zebra1993/SN2_Extension/SNModule.pdf

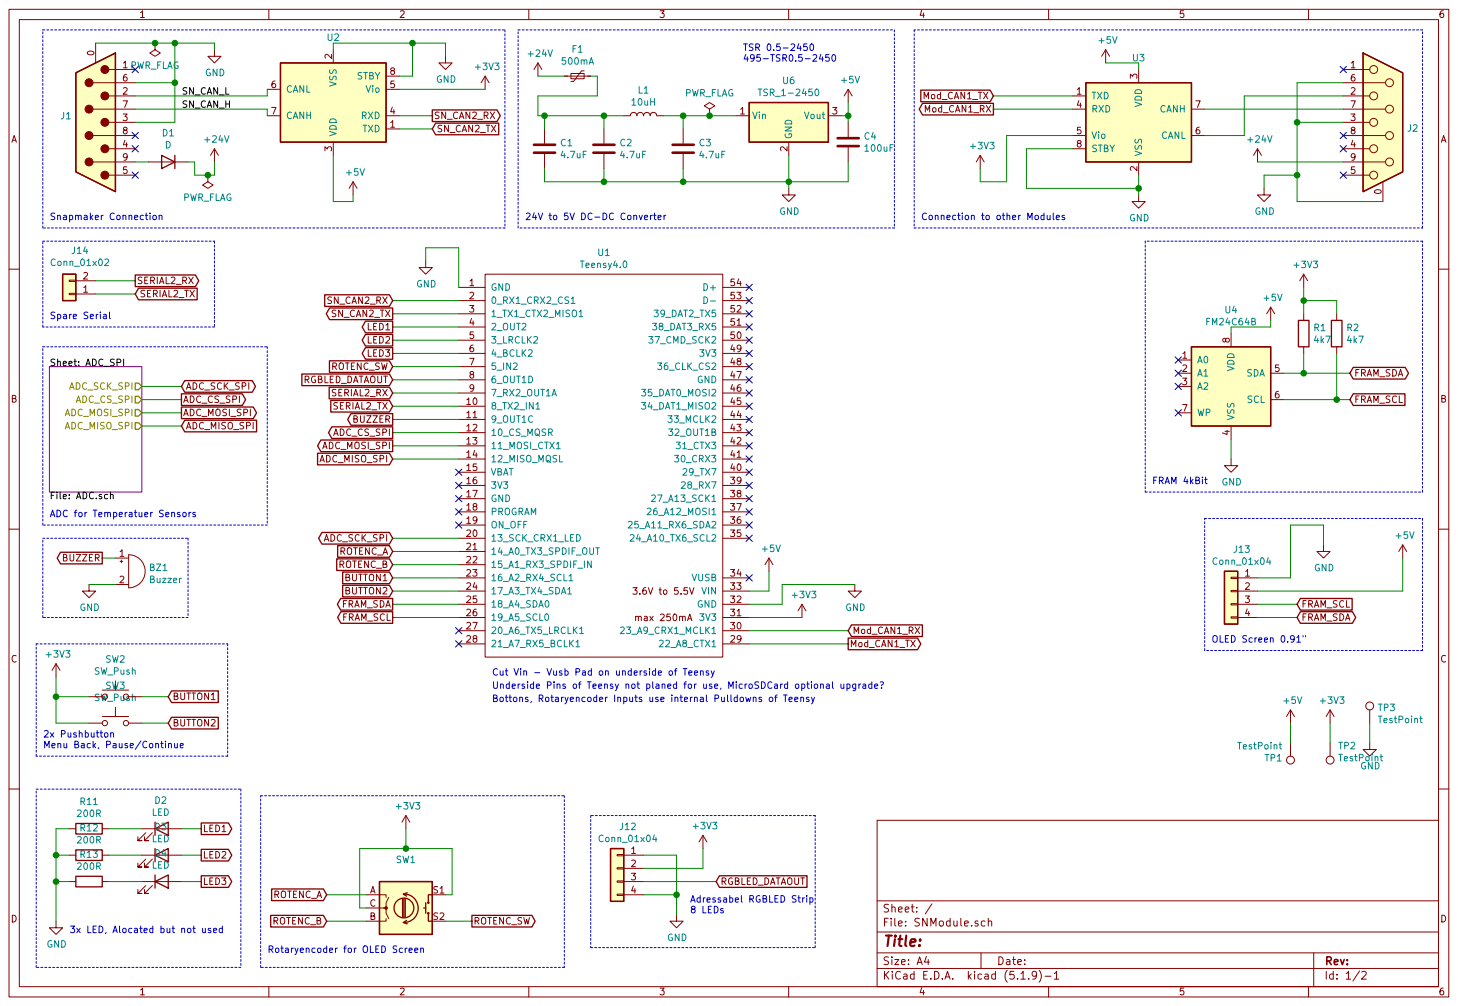
[picture p1: page 1]

3 RXD 4 Vio 5 CANL 6 CANH 7 STBY 8 U2 +24V

3 RXD 4 Vio 5 CANL 6 CANH 7 STBY 8 U3 GND GND

4 SDA 5 SCL 6 WP 7 VDD

8 LEDs Cut Vin - Vusb Pad on underside of Teensy
Underside Pins of Teensy not planed for use, MicroSDCard optional upgrade?

Id: 1/2 Title: File: SNModule.sch Sheet: /

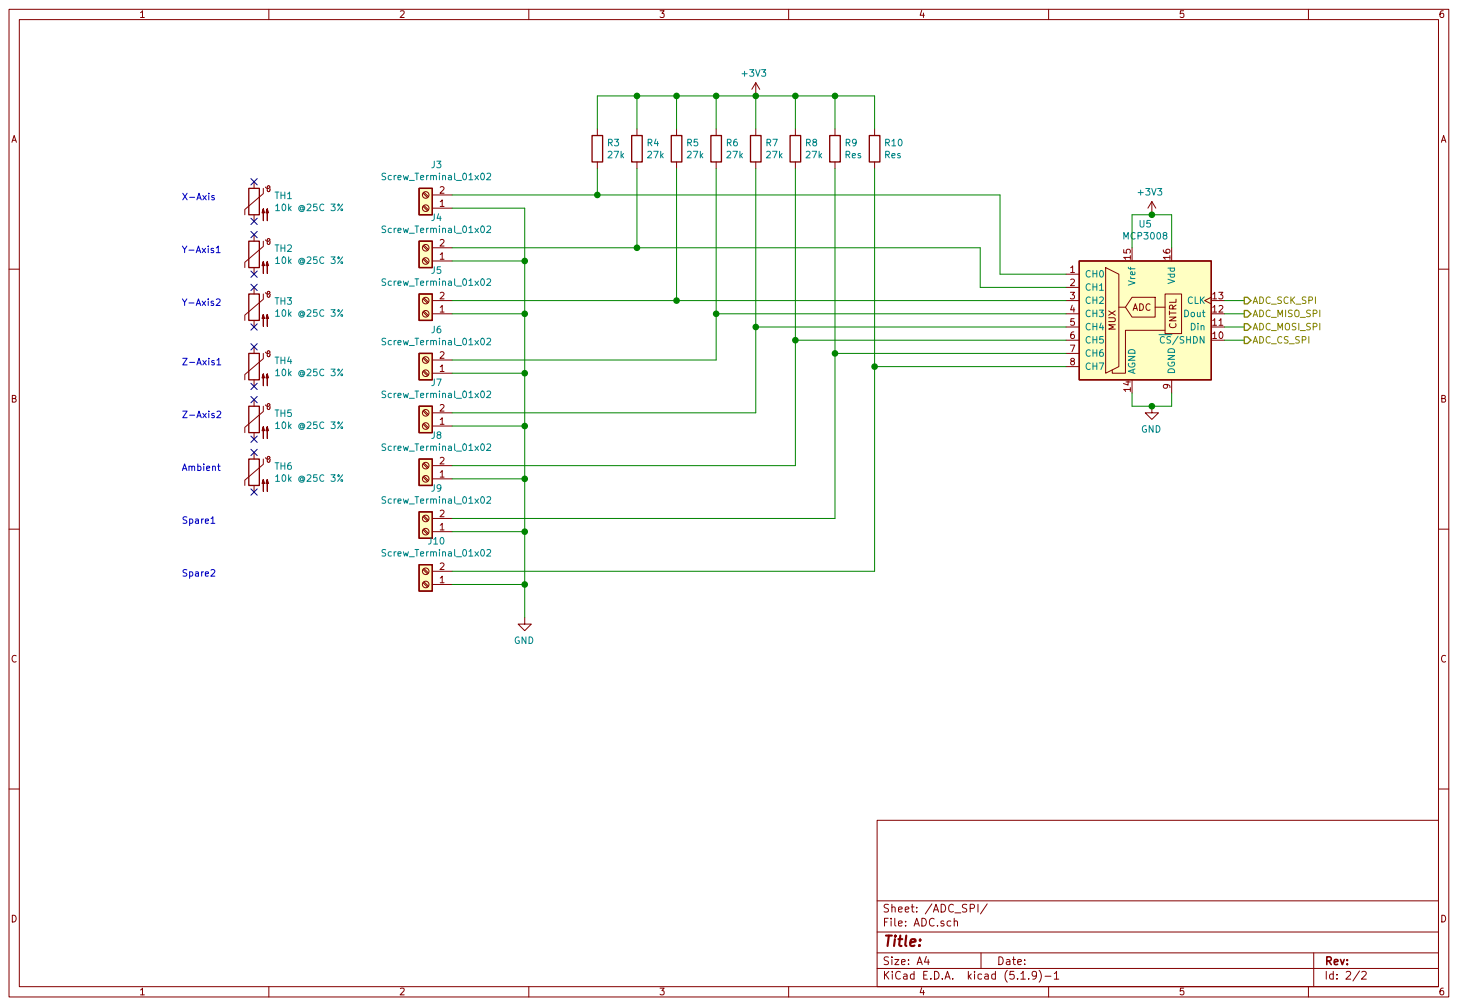
[picture p2: page 2]

Id: 2/2 Title: File: ADC.sch Sheet: /ADC_SPI/
