zebra1993/SN2_Extension/PCB_V1.pdf

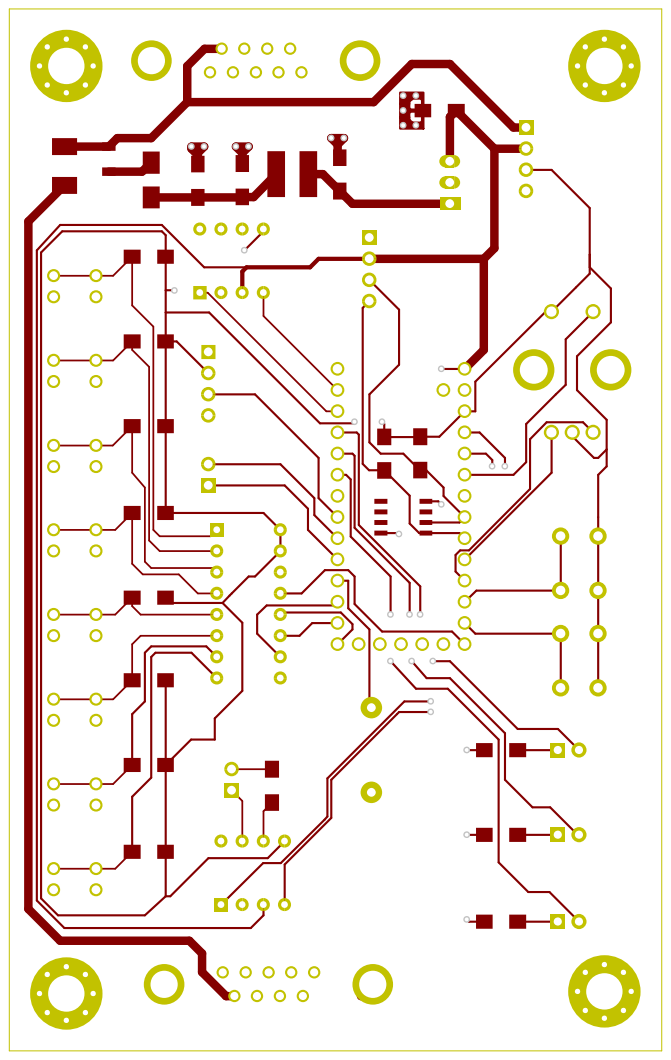
[picture p3: page 1]

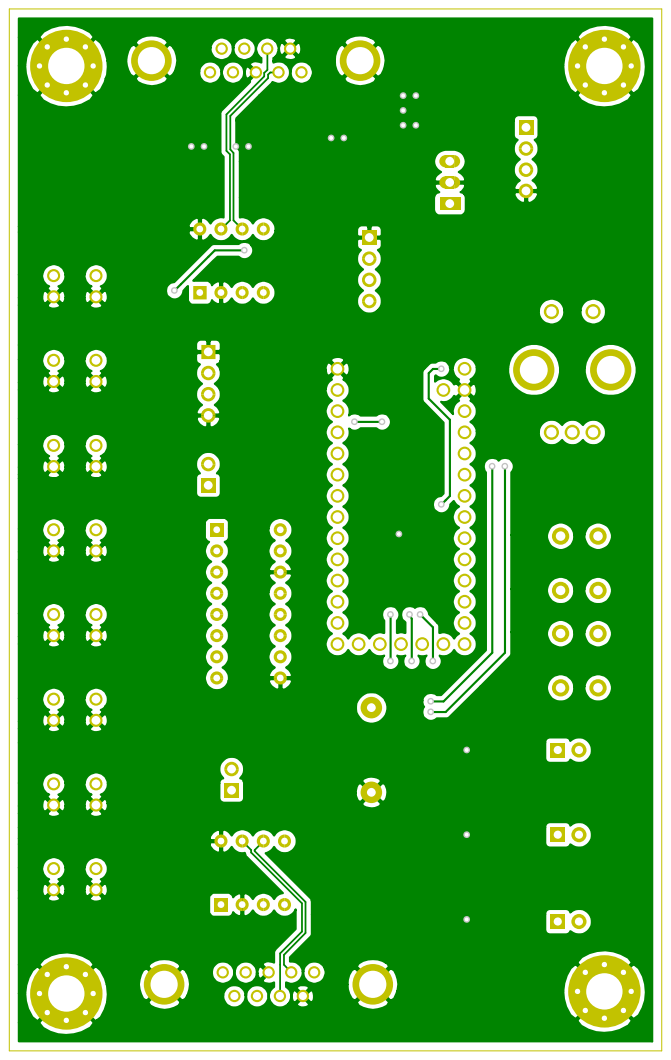
[picture p4: page 2]

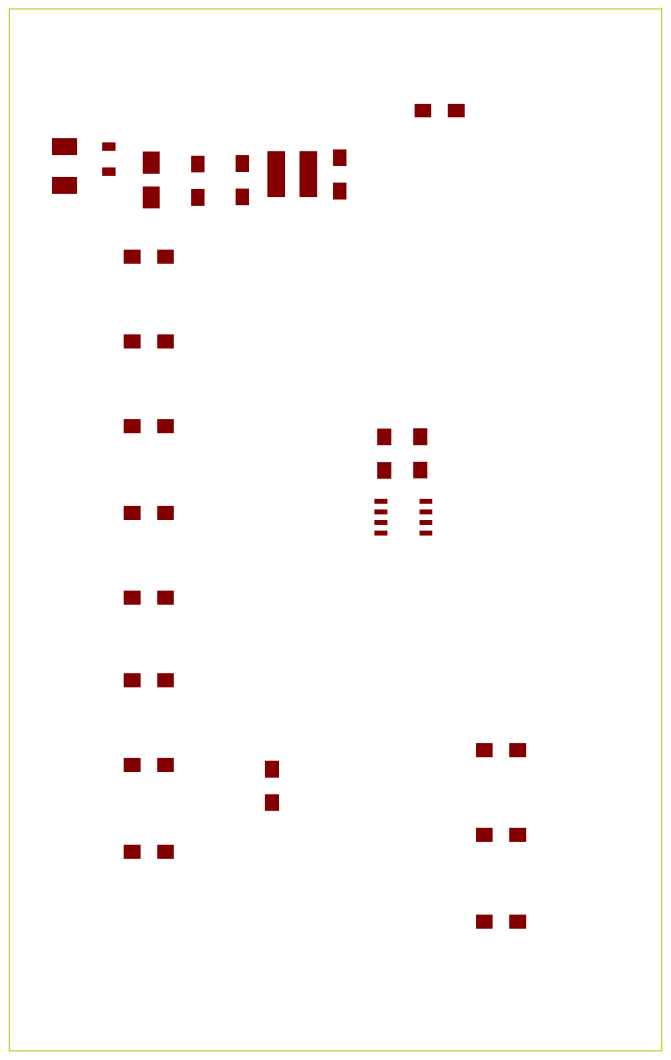
[picture p5: page 3]

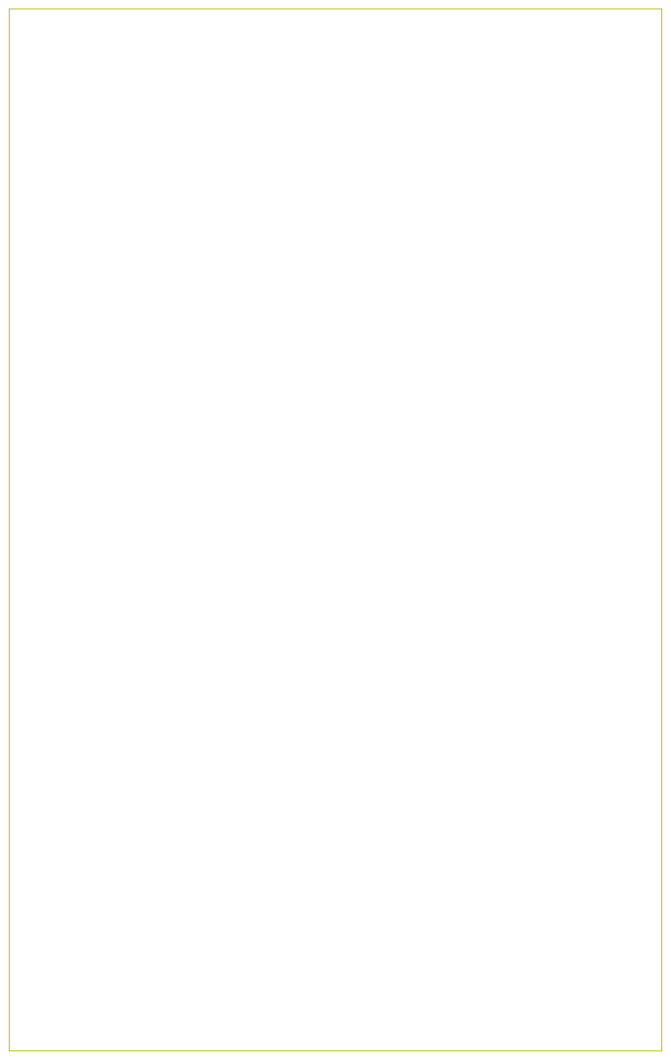
[picture p6: page 4]

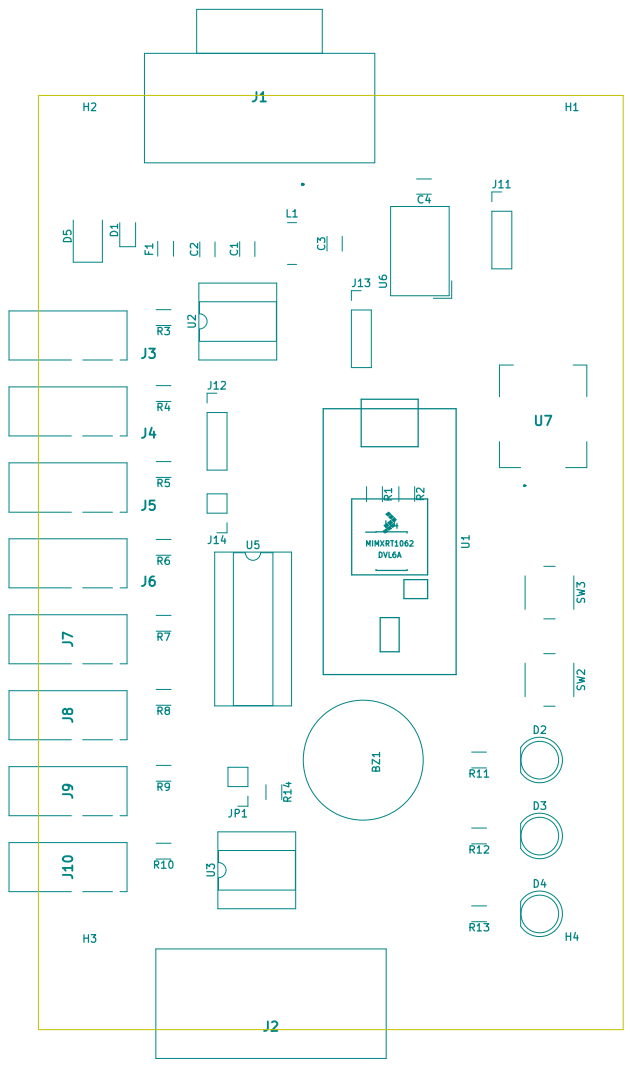
[picture p7: page 5]

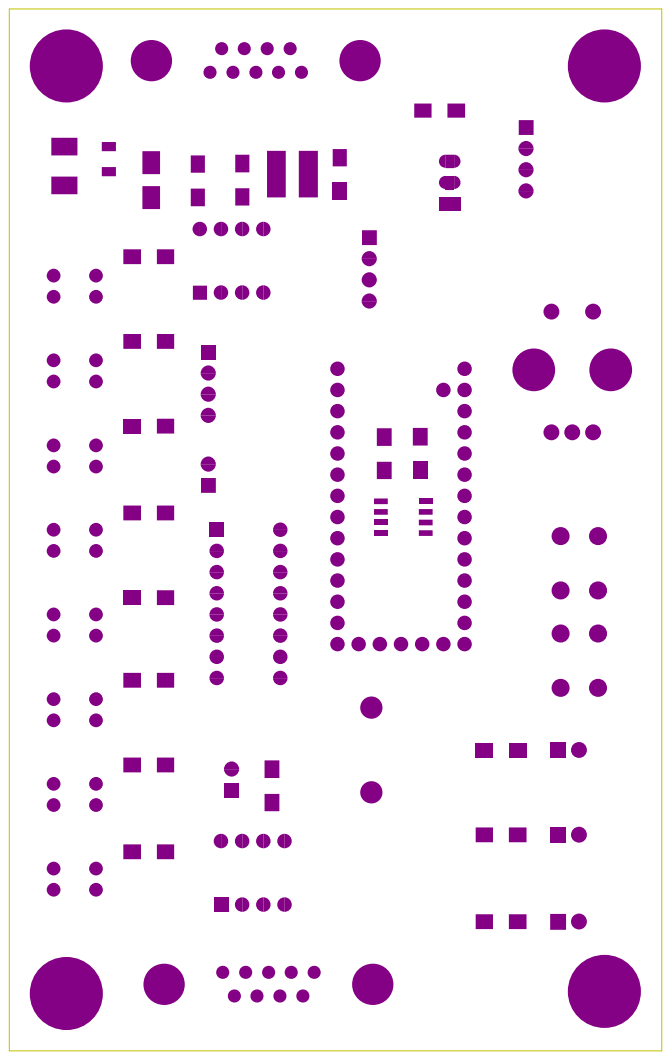
[picture p8: page 7]

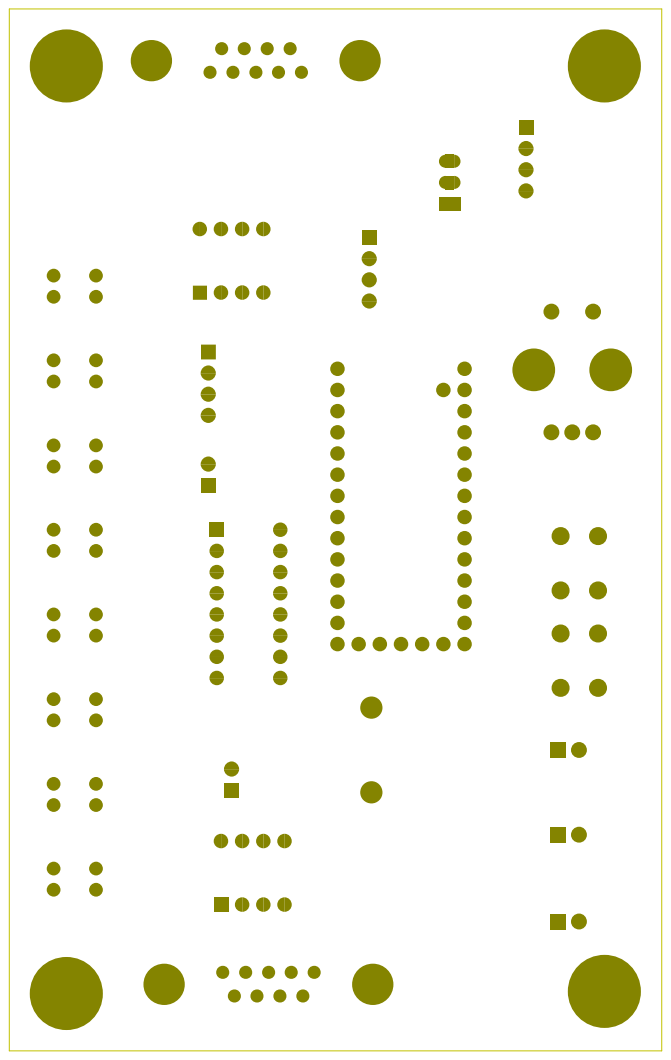
[picture p9: page 8]

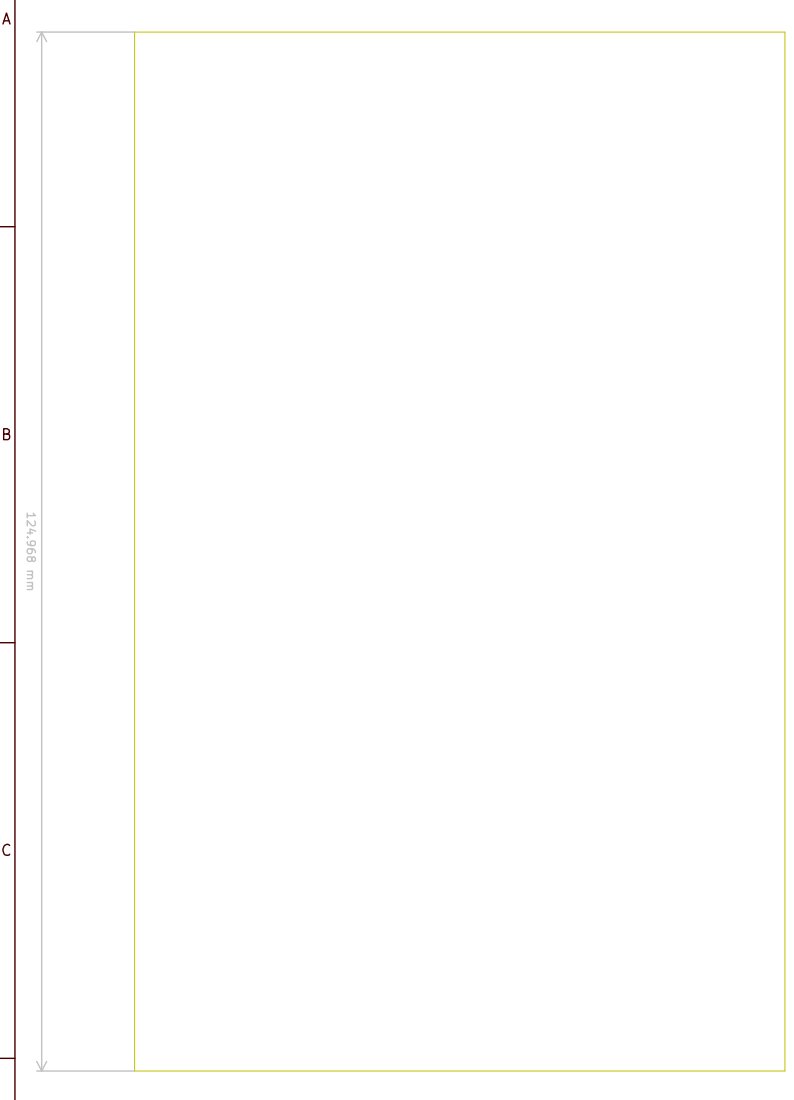
[picture p10: page 9]

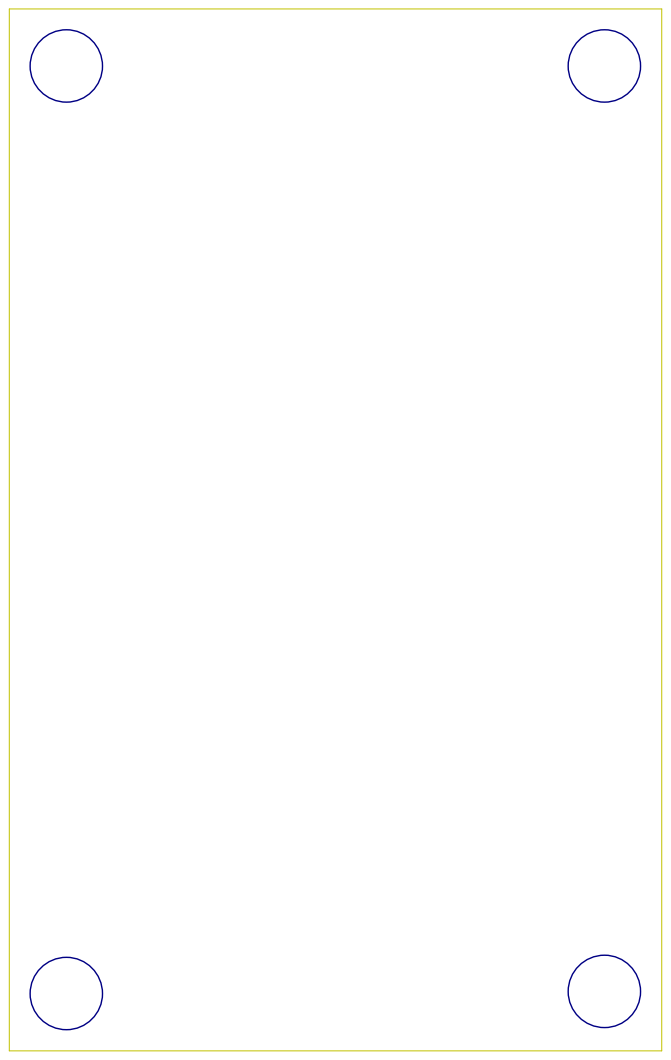
[picture p11: page 10]

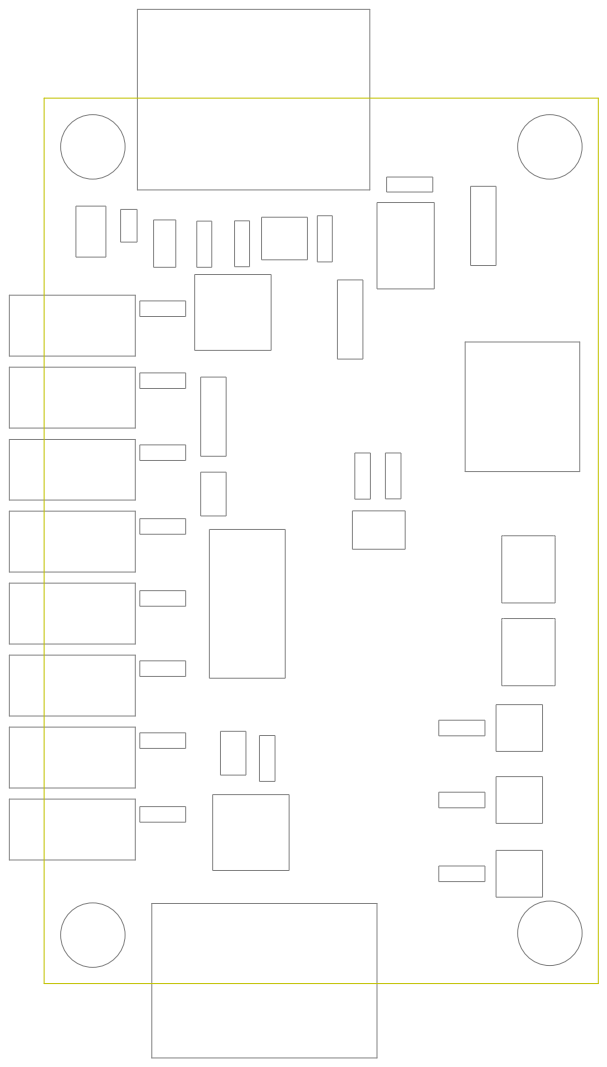
[picture p12: page 15]

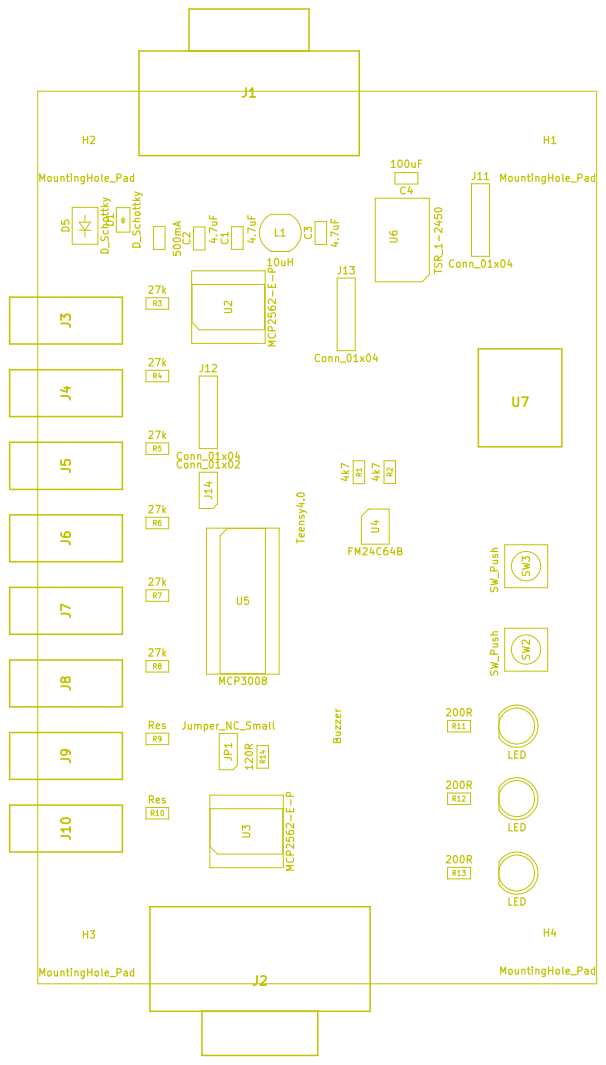
[picture p13: page 17]
