zebra1993/SN2_Extension/SNModule.kicad_pcb

## KiCad design SNModule.kicad_pcb (2021-04-09)

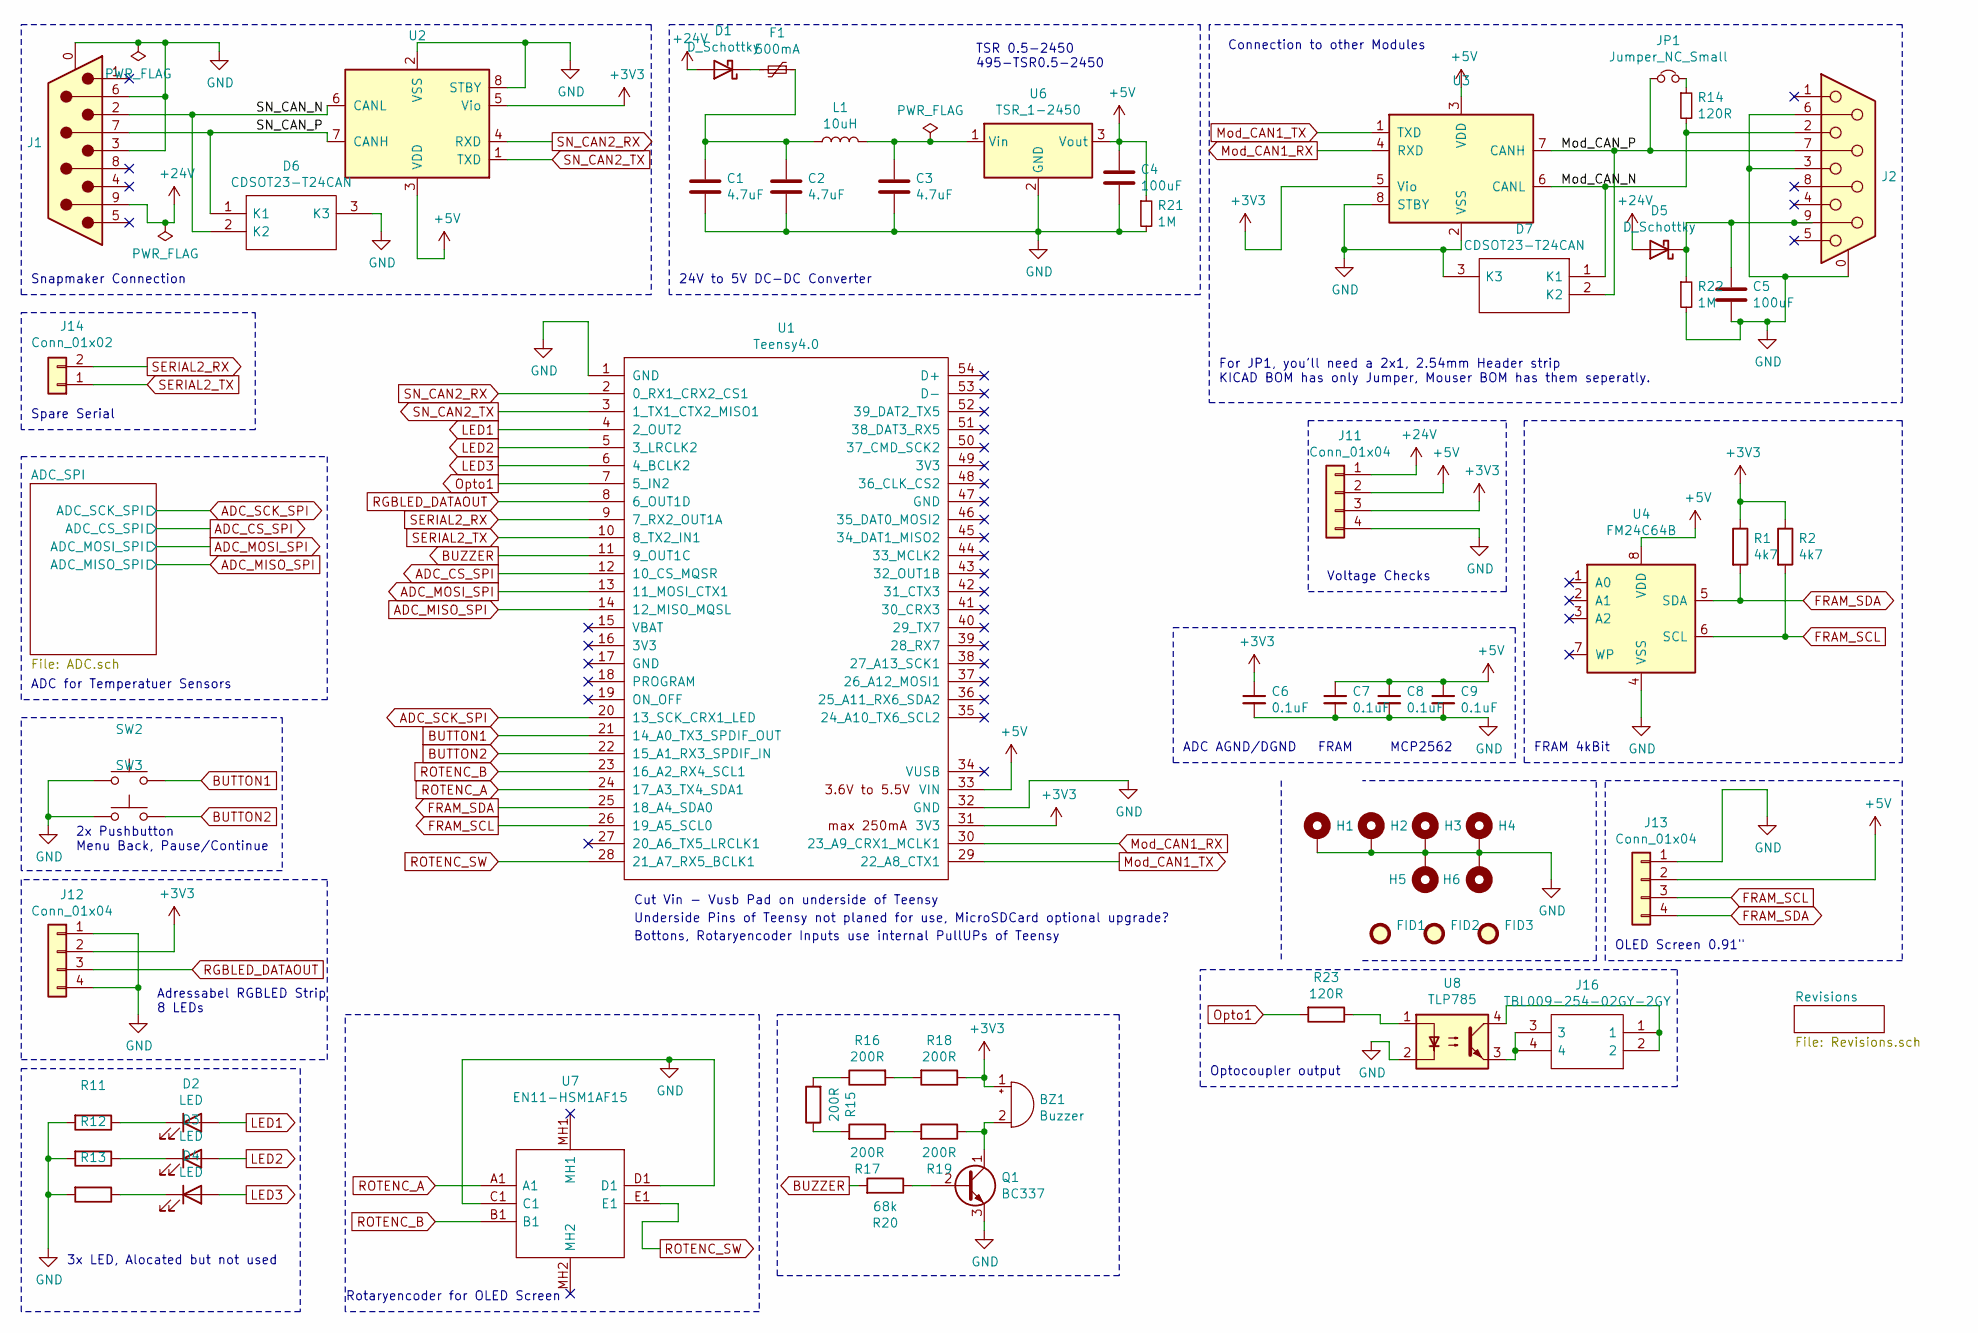
[picture p14: schematic SNModule.sch, Snapmaker2 CANbus extension]

Parts:
BZ1: Buzzer; Buzzer_TDK_12.2x6.5RM5; Manufacturer_Part_Number PS1240P02BT; Mouser Part Number 810-PS1240P02BT
C1, C2, C3: 4.7uF; C_1206_HandSoldering; Manufacturer_Part_Number C1206C475K5PACTU; Mouser Part Number 80-C1206C475K5P
C4, C5: 100uF; CP_Elec_6.3x7.7; Manufacturer_Part_Number EEE-FTH101XAL; Mouser Part Number 667-EEE-FTH101XAL
C6, C7, C8, C9: 0.1uF; C_1206_HandSoldering; Manufacturer_Part_Number VJ1206Y104KXXAC; Mouser Part Number 77-VJ1206Y104KXXAC
D1: D_Schottky; D_1206; Manufacturer_Part_Number SD1206T040S1R0; Mouser Part Number 581-SD1206T040S1R0
D2, D3, D4: LED; LED_D5.0mm_FlatTop; Manufacturer_Part_Number LTL-307GE; Mouser Part Number 859-LTL-307GE
D5: D_Schottky; D_2114; Manufacturer_Part_Number SD2114S040S8R0; Mouser Part Number 581-SD2114S040S8R0
D6, D7: CDSOT23-T24CAN; SOT-23; Mouser Part Number 652-CDSOT23-T24CAN
F1: 500mA; Fuse_SMD1206_HandSoldering; Manufacturer_Part_Number 0ZCJ0025AF2E; Mouser Part Number 530-0ZCJ0025AF2E
FID1, FID2, FID3: Fiducial; Fiducial_0.5mm_Dia_1mm_Outer
H1, H2, H3, H4, H5, H6: MountingHole_Pad; MountingHole_4.3mm_M4_Pad_Via
J1: DB9_Male_MountingHoles; D09P23A4GV00LF; Manufacturer_Part_Number D09P23A4GV00LF; Mouser Part Number 649-D09P23A4GV00LF
J2: DB9_Female_MountingHoles; D09S23A4GV00LF; Manufacturer_Part_Number D09S23A4GV00LF; Mouser Part Number 649-D09S23A4GV00LF
J11, J12, J13: Conn_01x04; Socket_Strip_Straight_1x04_Pitch2.54mm; Manufacturer_Part_Number SLW-104-01-T-S; Mouser Part Number 200-SLW10401TS
J14: Conn_01x02; Pin_Header_Straight_1x02_Pitch2.54mm; Manufacturer_Part_Number SLW-102-01-T-S; Mouser Part Number 200-SLW10201TS
J16: TBL009-254-02GY-2GY; TBL00925402GY2GY; Mouser Part Number 490-TBL00925402GY2GY
JP1: Jumper_NC_Small; Pin_Header_Straight_1x02_Pitch2.54mm; Manufacturer_Part_Number SX1100-B; Mouser Part Number 806-SX1100-B
L1: 10uH; L_TracoPower_TCK-047_5.2x5.8mm; Manufacturer_Part_Number TCK-047; Mouser Part Number 495-TCK-047
Q1: BC337; TO-92_Inline_Wide; Manufacturer_Part_Number BC33716TFR; Mouser Part Number 512-BC33716TFR
R1, R2: 4k7; R_1206_HandSoldering; Manufacturer_Part_Number CRCW12064K70FKEA; Mouser Part Number 71-CRCW1206-4.7K-E3
R11, R12, R13, R15, R16, R17, R18, R19: 200R; R_1206_HandSoldering; Manufacturer_Part_Number CRCW1206200RFKEA; Mouser Part Number 71-CRCW1206-200-E3
R14, R23: 120R; R_1206_HandSoldering; Manufacturer_Part_Number CRCW1206120RFKEAC; Mouser Part Number 71-CRCW1206120RFKEAC
R20: 68k; R_1206_HandSoldering; Manufacturer_Part_Number CRCW120668K0FKEA; Mouser Part Number 71-CRCW1206-68K-E3
R21, R22: 1M; R_1206_HandSoldering; Manufacturer_Part_Number CRCW12061M00FKEAC; Mouser Part Number 71-CRCW12061M00FKEAC
SW2, SW3: SW_Push; SW_PUSH_6mm_h4.3mm; Manufacturer_Part_Number ADTS61KV; Mouser Part Number 642-ADTS61KV
U1: Teensy4.0; Teensy40_THT; Manufacturer_Part_Number 4323; Mouser Part Number 485-4323
U2, U3: MCP2562-E-P; DIP-8_W7.62mm_Socket; Manufacturer_Part_Number MCP2562-E/P; Mouser Part Number 579-MCP2562-E/P
U4: FM24C64B; SOIC-8_3.9x4.9mm_Pitch1.27mm; Manufacturer_Part_Number FM24C64B-G; Mouser Part Number 877-FM24C64B-G
U6: TSR_1-2450; DCDC-Conv_TRACO_TSR-1; Manufacturer_Part_Number TSR0.5-2450; Mouser Part Number 495-TSR0.5-2450
U7: EN11-HSM1AF15; EN11HSM1AF15; Mouser Part Number 858-EN11-HSM1AF15
U8: TLP785; DIP-4_W7.62mm_LongPads; Manufacturer_Part_Number TLP785(D4-GR,F; Mouser Part Number 757-TLP785D4-GRF

Connections:
+3V3: BZ1.1 (-), C6.1, J11.3, J12.2, R1.1, R2.1, R18.1, U1.31 (3V3), U2.5 (Vio), U3.5 (Vio); also elsewhere on the board
+5V: C4.1, C7.1, C8.1, C9.1, J11.2, J13.2, R21.1, U1.33 (VIN), U2.3 (VDD), U3.3 (VDD), U4.8 (VDD), U6.3 (Vout)
+24V: D1.2 (A), D5.2 (A), J1.9, J11.1
/Mod_CAN_N: D7.1 (K1), J2.2, R14.2, U3.6 (CANL)
/Mod_CAN_P: D7.2 (K2), J2.7, JP1.1, U3.7 (CANH)
/SN_CAN_N: D6.2 (K2), J1.2, U2.6 (CANL)
/SN_CAN_P: D6.1 (K1), J1.7, U2.7 (CANH)
ADC_CS_SPI: U1.12 (10_CS_MQSR); also elsewhere on the board
ADC_MISO_SPI: U1.14 (12_MISO_MQSL); also elsewhere on the board
ADC_MOSI_SPI: U1.13 (11_MOSI_CTX1); also elsewhere on the board
ADC_SCK_SPI: U1.20 (13_SCK_CRX1_LED); also elsewhere on the board
BUTTON1: SW2.2, U1.21 (14_A0_TX3_SPDIF_OUT)
BUTTON2: SW3.2, U1.22 (15_A1_RX3_SPDIF_IN)
BUZZER: R20.2, U1.11 (9_OUT1C)
FRAM_SCL: J13.3, R2.2, U1.26 (19_A5_SCL0), U4.6 (SCL)
FRAM_SDA: J13.4, R1.2, U1.25 (18_A4_SDA0), U4.5 (SDA)
GND: C1.2, C2.2, C3.2, C4.2, C5.2, C6.2, C7.2, C8.2, C9.2, D6.3 (K3), D7.3 (K3), H1.1, H2.1, H3.1, H4.1, H5.1, H6.1, J1.0 (PAD), J1.3, J1.6, J2.0 (PAD), J2.3, J2.6, J11.4, J12.1, J12.4, J13.1, Q1.3 (E), R11.2, R12.2, R13.2, R21.2, R22.2, SW2.1, SW3.1, U1.1 (GND), U1.32 (GND), U2.2 (VSS), U2.8 (STBY), U3.2 (VSS), U3.8 (STBY), U4.4 (VSS), U6.2 (GND), U7.C1, U7.D1, U8.2; also elsewhere on the board
LED1: D2.2 (A), U1.4 (2_OUT2)
LED2: D3.2 (A), U1.5 (3_LRCLK2)
LED3: D4.2 (A), U1.6 (4_BCLK2)
Mod_CAN1_RX: U1.30 (23_A9_CRX1_MCLK1), U3.4 (RXD)
Mod_CAN1_TX: U1.29 (22_A8_CTX1), U3.1 (TXD)
unnamed: BZ1.2 (+), Q1.1 (C), R19.1
unnamed: C1.1, C2.1, F1.1, L1.1
unnamed: C3.1, L1.2, U6.1 (Vin)
unnamed: C5.1, D5.1 (K), J2.9, R22.1
unnamed: D1.1 (K), F1.2
unnamed: D2.1 (K), R11.1
unnamed: D3.1 (K), R12.1
unnamed: D4.1 (K), R13.1
unnamed: J16.1, J16.2, U8.4
unnamed: J16.3, J16.4, U8.3
unnamed: JP1.2, R14.1
unnamed: Q1.2 (B), R20.1
unnamed: R15.1, R17.2
unnamed: R15.2, R16.1
unnamed: R16.2, R18.2
unnamed: R17.1, R19.2
unnamed: R23.1, U8.1
Opto1: R23.2, U1.7 (5_IN2)
RGBLED_DATAOUT: J12.3, U1.8 (6_OUT1D)
ROTENC_A: U1.24 (17_A3_TX4_SDA1), U7.A1
ROTENC_B: U1.23 (16_A2_RX4_SCL1), U7.B1
ROTENC_SW: U1.28 (21_A7_RX5_BCLK1), U7.E1
SERIAL2_RX: J14.2, U1.9 (7_RX2_OUT1A)
SERIAL2_TX: J14.1, U1.10 (8_TX2_IN1)
SN_CAN2_RX: U1.2 (0_RX1_CRX2_CS1), U2.4 (RXD)
SN_CAN2_TX: U1.3 (1_TX1_CTX2_MISO1), U2.1 (TXD)

Notes on the sheet:
Cut Vin - Vusb Pad on underside of Teensy
Underside Pins of Teensy not planed for use, MicroSDCard optional upgrade?
24V to 5V DC-DC Converter
Snapmaker Connection
Adressabel RGBLED Strip 8 LEDs
ADC for Temperatuer Sensors
Spare Serial
Rotaryencoder for OLED Screen
2x Pushbutton Menu Back, Pause/Continue
Bottons, Rotaryencoder Inputs use internal PullUPs of Teensy
OLED Screen 0.91"
FRAM 4kBit
Voltage Checks
3x LED, Alocated but not used
MCP2562
FRAM
ADC AGND/DGND
For JP1, you'll need a 2x1, 2.54mm Header strip KICAD BOM has only Jumper, Mouser BOM has them seperatly.
Connection to other Modules
TSR 0.5-2450 495-TSR0.5-2450
Optocoupler output

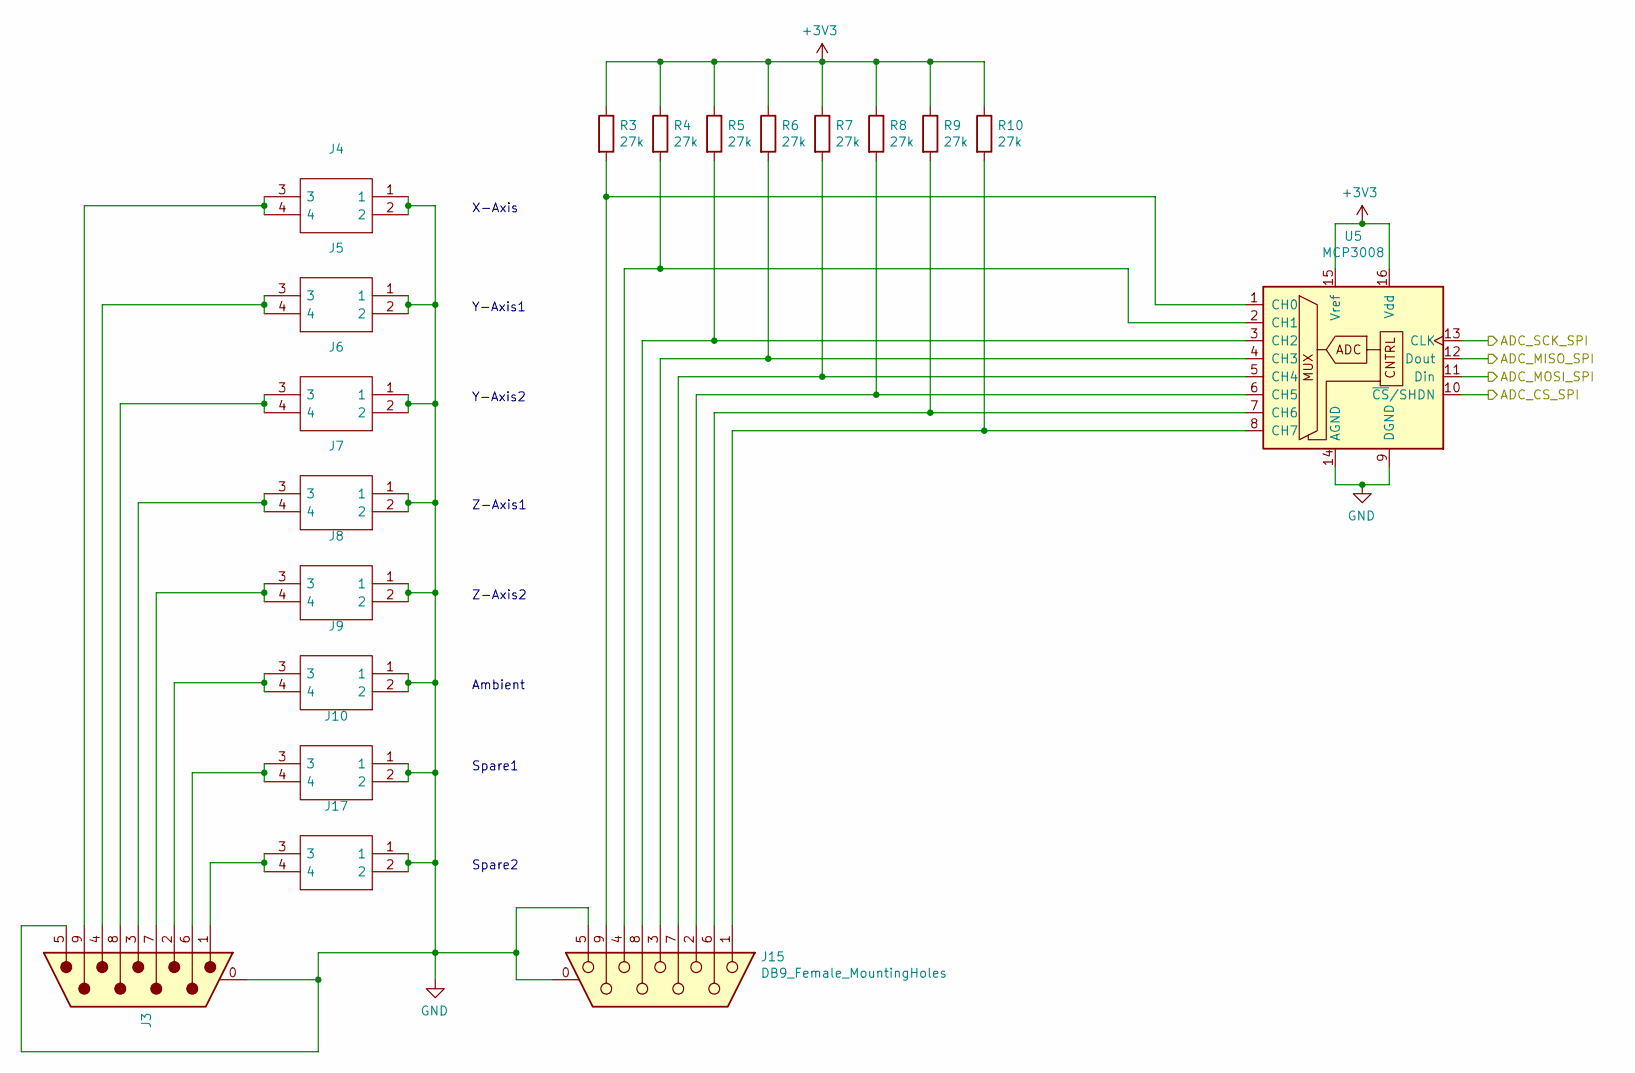
[picture p15: schematic ADC.sch, Snapmaker2 CANbus extension]

Parts:
J3: DB9_Male_MountingHoles; D09P23A4GV00LF; Manufacturer_Part_Number D09P23A4GV00LF; Mouser Part Number 649-D09P23A4GV00LF
J4, J5, J6, J7, J8, J9, J10, J17: TBL009-254-02GY-2GY; TBL00925402GY2GY; Mouser Part Number 490-TBL00925402GY2GY
J15: DB9_Female_MountingHoles; D09S23A4GV00LF; Mouser Part Number 649-D09S23A4GV00LF
R3, R4, R5, R6, R7, R8: 27k; R_1206_HandSoldering; Manufacturer_Part_Number CRCW120627K0FKEA; Mouser Part Number 71-CRCW1206-27K-E3
R9, R10: 27k; R_1206_HandSoldering; Mouser Part Number 71-CRCW1206-27K-E3
U5: MCP3008; DIP-16_W7.62mm_Socket; Manufacturer_Part_Number MCP3008-I/P; Mouser Part Number 579-MCP3008-I/P

Connections:
+3V3: R3.1, R4.1, R5.1, R6.1, R7.1, R8.1, R9.1, R10.1, U5.15 (Vref), U5.16 (Vdd); also elsewhere on the board
ADC_CS_SPI: U5.10 (~CS~/SHDN); also elsewhere on the board
ADC_MISO_SPI: U5.12 (Dout); also elsewhere on the board
ADC_MOSI_SPI: U5.11 (Din); also elsewhere on the board
ADC_SCK_SPI: U5.13 (CLK); also elsewhere on the board
GND: J3.0 (PAD), J3.5, J4.1, J4.2, J5.1, J5.2, J6.1, J6.2, J7.1, J7.2, J8.1, J8.2, J9.1, J9.2, J10.1, J10.2, J15.0 (PAD), J15.5, J17.1, J17.2, U5.9 (DGND), U5.14 (AGND); also elsewhere on the board
unnamed: J3.2, J9.3, J9.4
unnamed: J3.3, J7.3, J7.4
unnamed: J3.4, J5.3, J5.4
unnamed: J3.7, J8.3, J8.4
unnamed: J3.8, J6.3, J6.4
unnamed: J3.9, J4.3, J4.4
unnamed: J3.6, J10.3, J10.4
unnamed: J15.1, R10.2, U5.8 (CH7)
unnamed: J15.2, R8.2, U5.6 (CH5)
unnamed: J15.3, R6.2, U5.4 (CH3)
unnamed: J15.4, R4.2, U5.2 (CH1)
unnamed: J15.6, R9.2, U5.7 (CH6)
unnamed: J15.7, R7.2, U5.5 (CH4)
unnamed: J15.8, R5.2, U5.3 (CH2)
unnamed: J15.9, R3.2, U5.1 (CH0)
unnamed: J3.1, J17.3, J17.4

Notes on the sheet:
Spare1
Spare2
X-Axis
Y-Axis1
Y-Axis2
Z-Axis1
Z-Axis2
Ambient

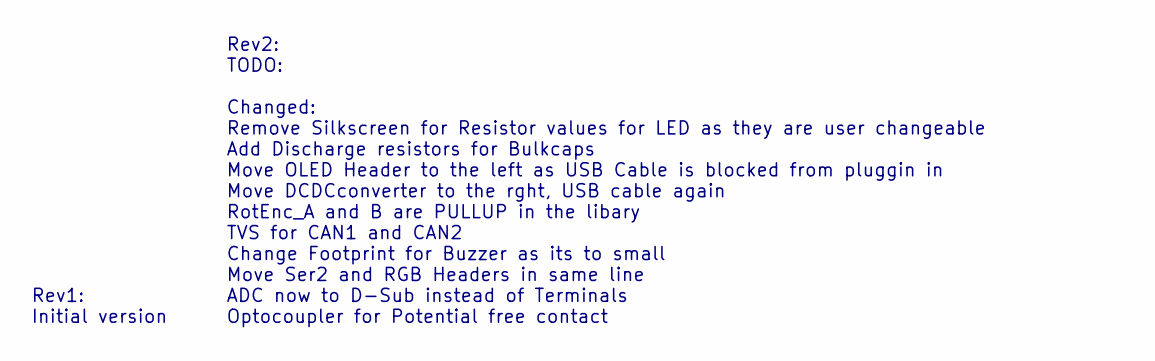
[picture p16: schematic Revisions.sch]

Notes on the sheet:
Rev1: Initial version
Rev2: TODO: Changed: Remove Silkscreen for Resistor values for LED as they are user changeable Add Discharge resistors for Bulkcaps Move OLED Header to the left as USB Cable is blocked from pluggin in Move DCDCconverter to the rght, USB cable again RotEnc_A and B are PULLUP in the libary TVS for CA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

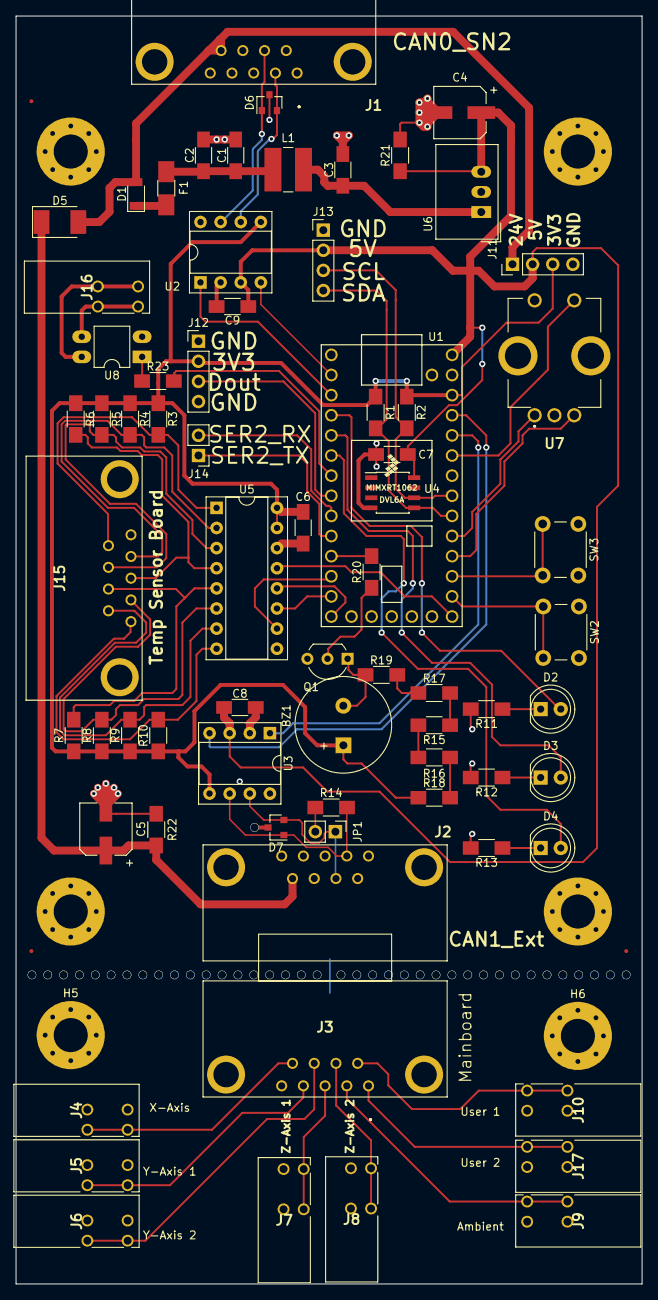
[picture p17: board SNModule.kicad_pcb from above]

Board: 2 copper layers, 79.0 x 160.0 mm, 80 parts (0 on the bottom side), 64 nets.
