zebra1993/SN2_Extension/(commit log)

2021-01-16 Initial Comit to Github, Rev1 of Board
    [ADC.sch, SNModule.kicad_pcb, SNModule.sch]
2021-01-30 Rev1
    Orderd and ariving soon
    [ADC.sch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]
2021-02-06 Rev1.1
    Mostly as Orderd, some small none function changes to Rev1
    [ADC.sch, Revisions.sch, SNModule.sch]
2021-04-09 Rev2 done
    Orderd and Assembeld PCB, works sofar, no magic Smoke sofar :D
    [ADC.sch, Revisions.sch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]
2023-12-09 Last firmware of the Module
    Firmware is as is, OLED did work somewhat, Beeper worked. Canbus mostly? if you set the OLED screen to update to often, your CANbus will start to have issues.
    Check "../include/Designstuff.h" for some notes, code in geenral has a bunch of coments in it. its been ages since ive worked on it though.
    You'll need a modified controller version to allow to send custom packets to custom IDs.
    Unfortunatly i dont have that firmware anymore. (its vastly out of date anyway)
    Its basicly an additional M-Code that takes the arguments to be sent out. (Use what ever Number you want to use though)
    (M instead of G Code because its not Geometry but Misellaneous in its use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
